MaravallLab/aMAZEing-maze/firmware/micropython/README.md

## code to run the PCA9685 on micropython

this leverages the Adafruit library which is currently not being actively developed.
