MaravallLab/aMAZEing-maze/docs/source/overview.rst

Overview
========

The Mice-Maze project provides a modular system for researchers to investigate rodent exploration behavior and sensory cue processing. The maze's flexible design includes interchangeable components and precise control of environmental stimuli. This documentation details the hardware and software requirements, assembly instructions, and usage guidelines.
