MaravallLab/aMAZEing-maze/docs/source/software.rst

Software Documentation
======================

Code Overview
-------------
- The repository includes:
  - Scripts for video processing and analysis.
  - Code to control maze stimuli and motor functions.

Running the Software
--------------------
1. Launch the Python script to initialize the experiment.
2. Adjust camera settings and stimuli parameters as needed.
3. Begin the experiment and monitor data collection.
