MaravallLab/aMAZEing-maze/docs/source/iindex.rst

.. Mice maze documentation master file, created by
   sphinx-quickstart on Thu Oct 10 16:22:44 2024.
   You can adapt this file completely to your liking, but it should at least
   contain the root `toctree` directive.

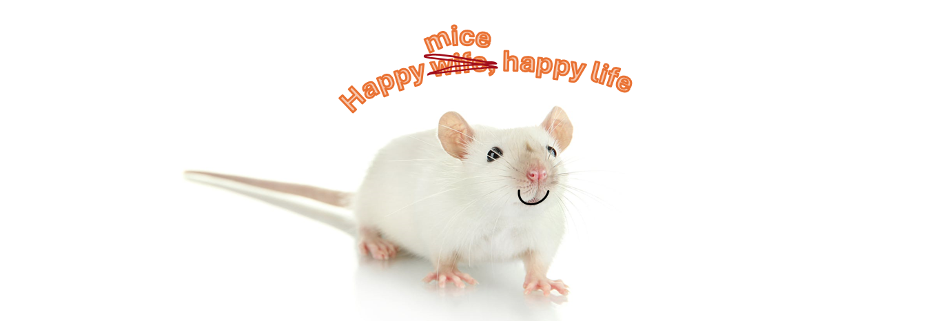
[picture p7: docs/source/_static/images/happy_mouse.png]


the aMAZEing maze documentation
=======================

**Active exploration setup for rodents**
This is a repository for building and running an experiment investigating how sensory cues affect mouse exploration in a modifiable maze.

Check out the :doc:`usage` section for further information, including how to :ref:`install <getting_started>` the project.

Welcome to Mice-Maze Documentation!
====================================

.. toctree::
   :maxdepth: 2
   :caption: Contents

   overview
   getting_started
   hardware
   software
   usage
   examples
   troubleshooting
   references

Indices and tables
==================
* :ref:`genindex`
* :ref:`modindex`
* :ref:`search`
