MaravallLab/aMAZEing-maze/archive/maze01/code/auditory/vocalisations/README.md

Recordings from the study ["Ultrasonic courtship vocalizations of male house mice contain distinct individual signatures"](https://doi.org/10.1016/j.anbehav.2020.09.006).  

Available on [Zenodo](https://zenodo.org/records/5771669)
