MaravallLab/aMAZEing-maze/docs/_static/images/mouse_ban.png

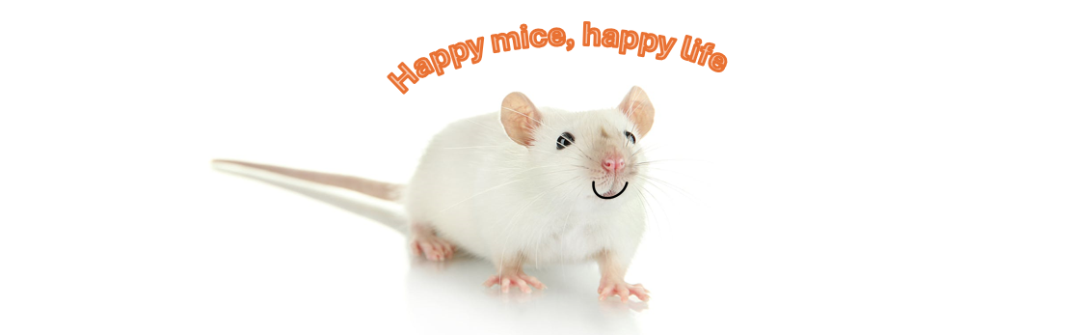
docs/_static/images/mouse_ban.png
