MaravallLab/aMAZEing-maze/docs/images/floor_plate.png

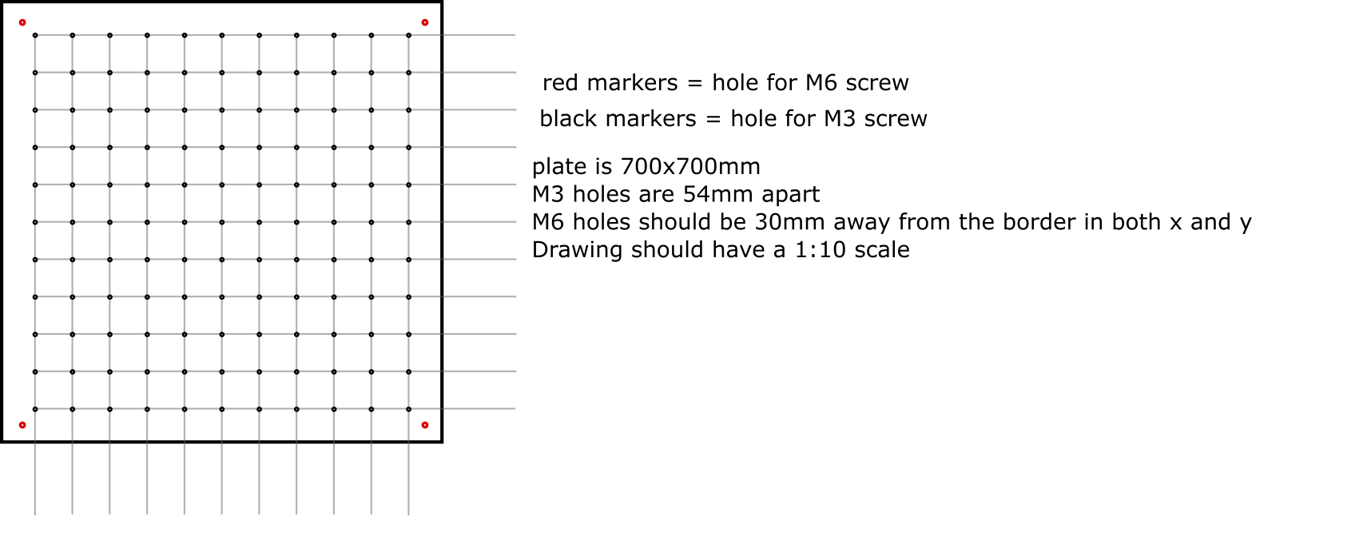
docs/images/floor_plate.png
