MaravallLab/aMAZEing-maze/docs/images/task_design.png

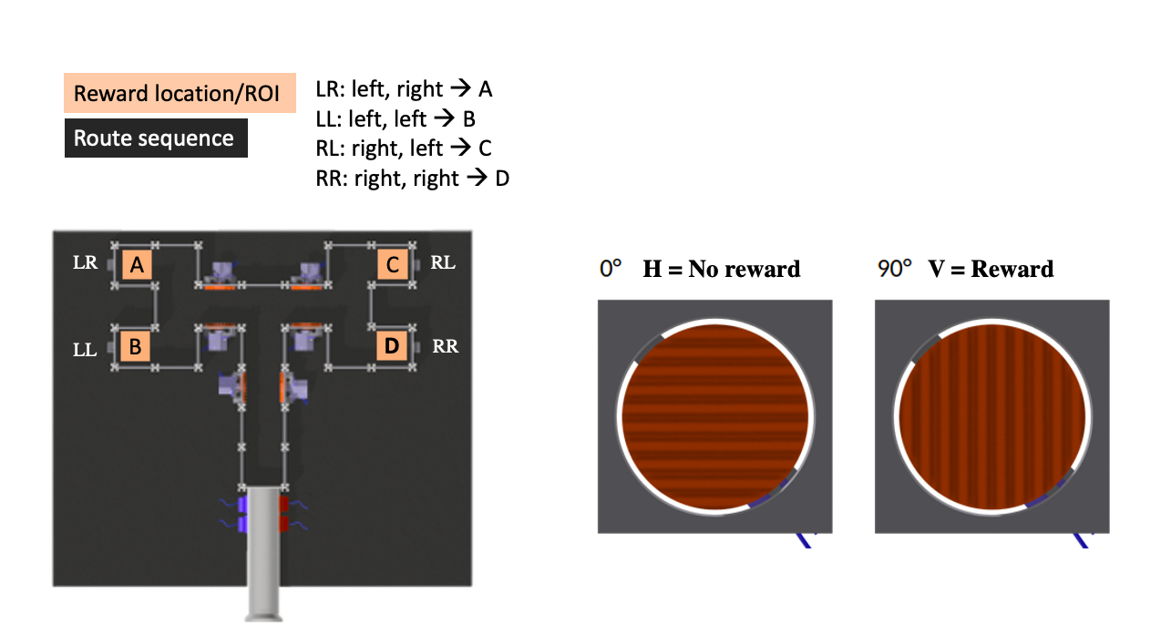
docs/images/task_design.png
