MaravallLab/aMAZEing-maze/docs/images/topplate.jpg

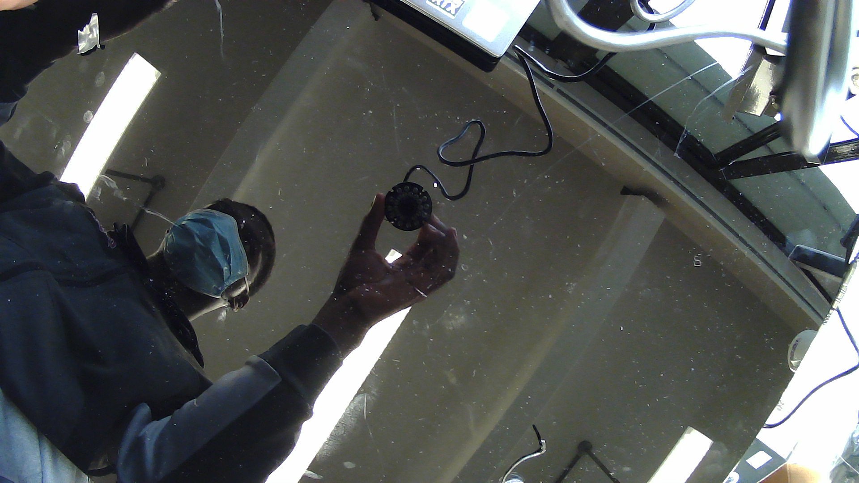
docs/images/topplate.jpg
