MaravallLab/aMAZEing-maze/hardware/drawings/task_design_2.png

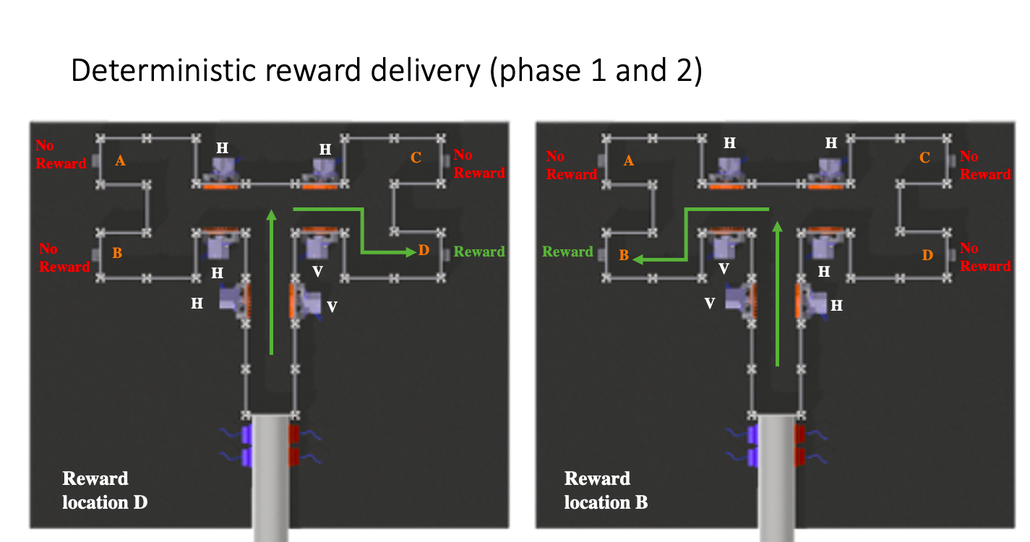
hardware/drawings/task_design_2.png
