MaravallLab/aMAZEing-maze/hardware/drawings/Task_design_3.png

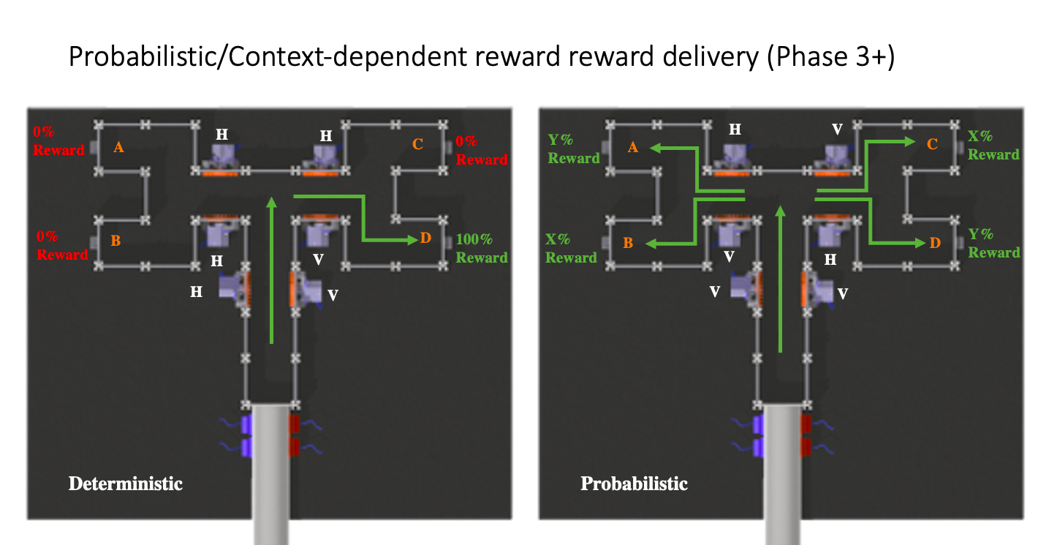
hardware/drawings/Task_design_3.png
