MaravallLab/aMAZEing-maze/hardware/photos/m3_16mm_screw_nut.jpg

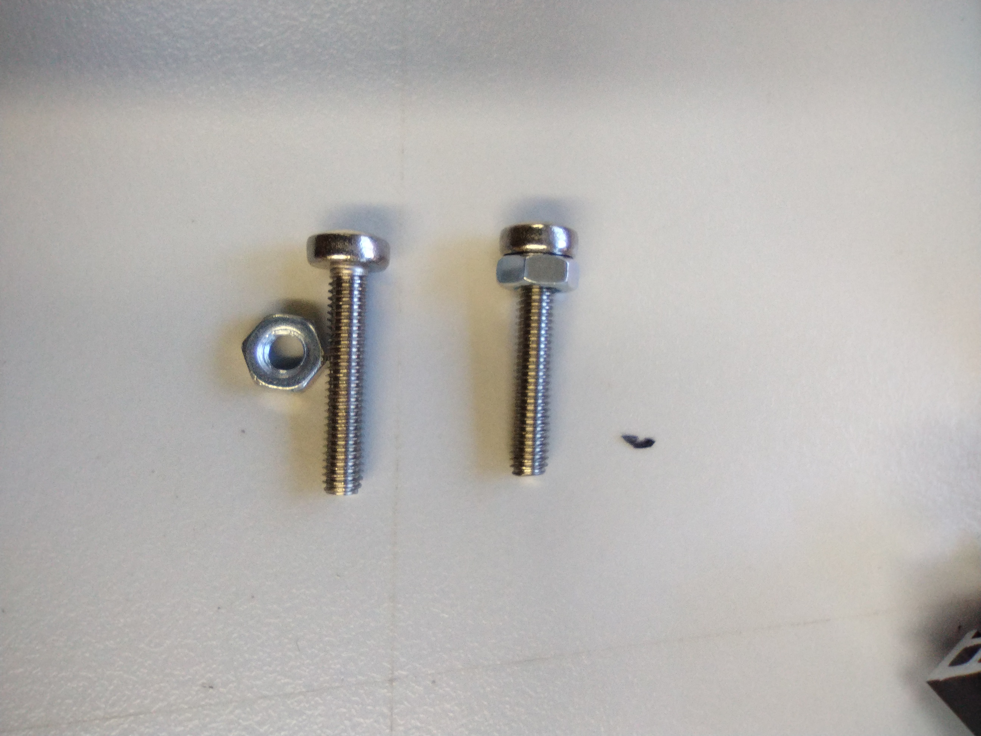
hardware/photos/m3_16mm_screw_nut.jpg
