MaravallLab/aMAZEing-maze/hardware/photos/topplate_view_infrared1.jpg

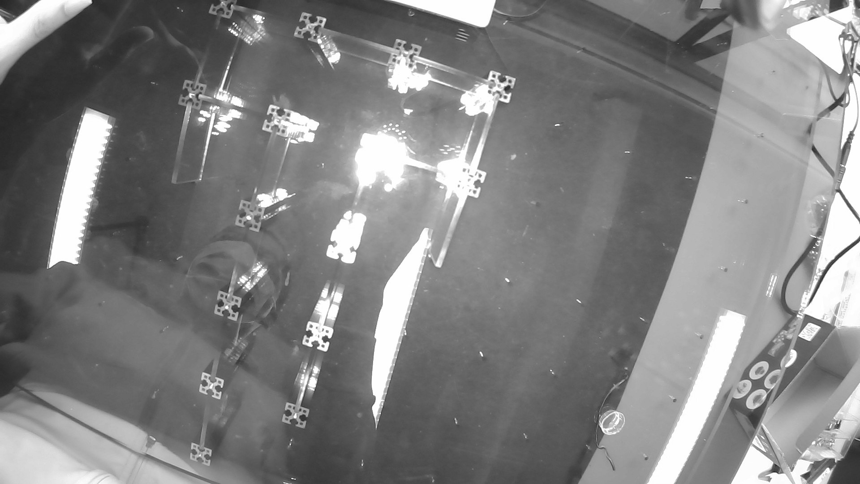
hardware/photos/topplate_view_infrared1.jpg
