MaravallLab/aMAZEing-maze/hardware/photos/topplate_view_infrared2.jpg

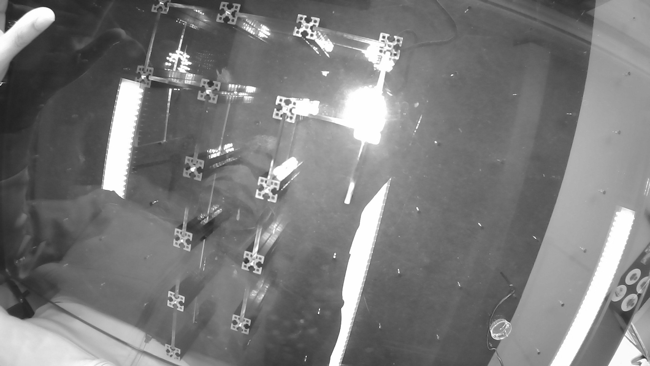
hardware/photos/topplate_view_infrared2.jpg
