MaravallLab/aMAZEing-maze/docs/hardware/materials.md

# Materials and suppliers

Where the lab bought the parts. These are the suppliers used in the United Kingdom; equivalents elsewhere are fine, the specifications on the [dimensions](dimensions.md) page are what matter.

## Suppliers

- local company for acrylic: https://www.brightonandhoveplastics.co.uk/index.php/products-acrylic_sheet/?k=23991:5::
- makerbeam shop https://www.makerbeam.com/makerbeamxl/makerbeamxl-15x15mm-profile-lengths-anodised-in-bl/
- screwfix for bolts https://www.screwfix.com/p/easyfix-bright-zinc-plated-pan-head-machine-screws-m3-x-20mm-25-pack/5875j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

For an 4 arm maze, we need (with spares) 50 side panels and 50 makerbeam posts, celing and floor plates.
Also need M3 bolts.
