MaravallLab/aMAZEing-maze/hardware/3dmodels/camera_holder/camera_box_v3.FCStd

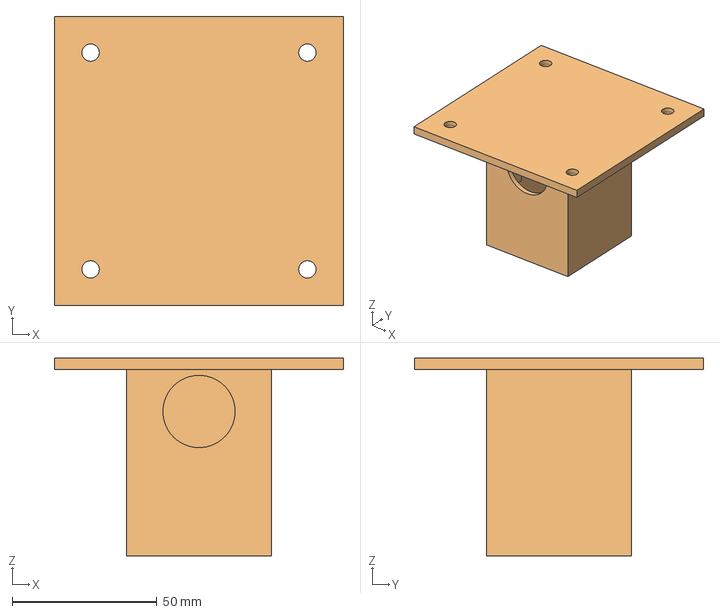
[picture p17: CAD file, 2026-04-02]
hardware/3dmodels/camera_holder/camera_box_v3.FCStd
100.0 x 100.0 x 68.5 mm
