MaravallLab/aMAZEing-maze/hardware/3dmodels/eight_arm_maze/eight_arm_maze_modified.FCStd

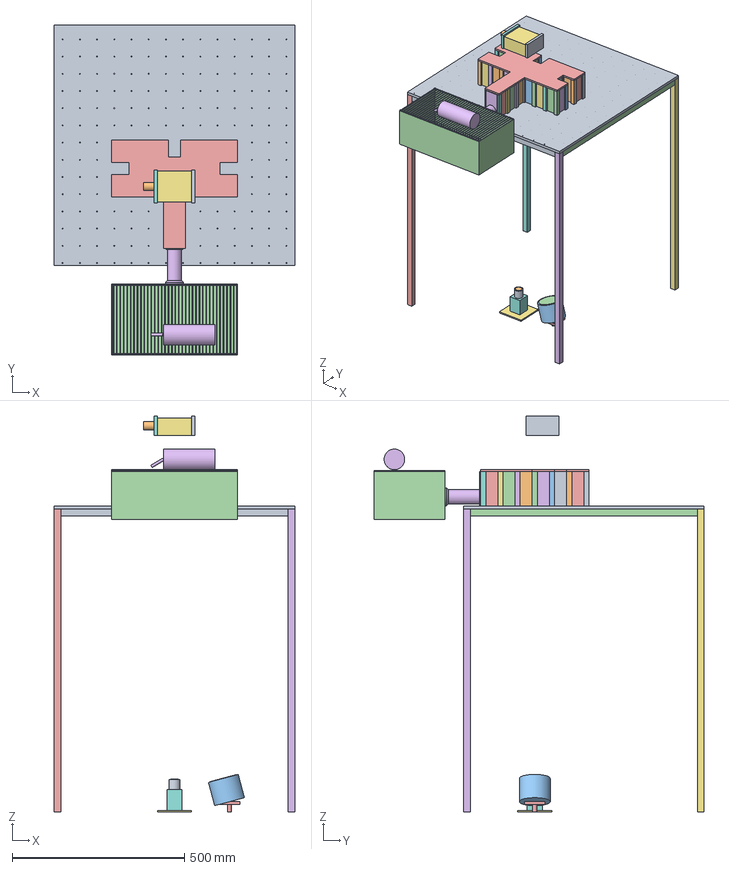
[picture p18: CAD file, 2026-09-24]
hardware/3dmodels/eight_arm_maze/eight_arm_maze_modified.FCStd
700.0 x 960.5 x 1151.0 mm
baseplate
panel001
panel002
panel003
panel004
panel005
panel006
panel007
panel008
panel009
panel010
panel011
panel012
panel013
panel014
panel015
panel016
panel017
panel018
panel019
panel020
panel021
panel022
panel023
panel024
panel025
panel026
panel027
panel028
panel029
panel030
panel031
panel032
panel033
panel034
panel035
panel036
panel037
post001
post002
post003
post004
post005
post006
post007
post008
post009
post010
post011
post012
post013
post014
post015
post016
post017
post018
post019
post020
post021
post022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
