MaravallLab/aMAZEing-maze/hardware/3dmodels/electronics_enclosure_bottom_v2.stl

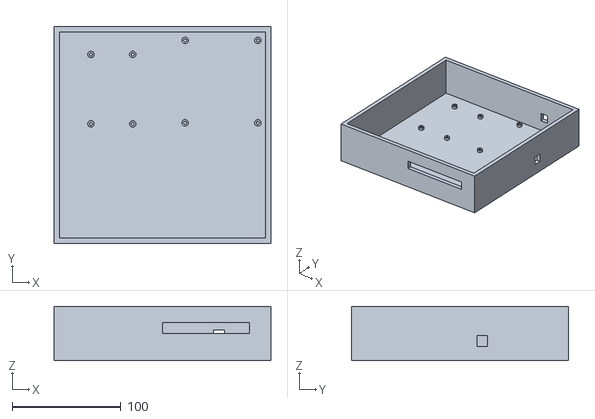
[picture p19: CAD file, 2026-04-02]
hardware/3dmodels/electronics_enclosure_bottom_v2.stl
200.0 x 200.0 x 50.0
