MaravallLab/aMAZEing-maze/hardware/3dmodels/maze_parts/maze_cover/maze_cover_B_v4.FCStd

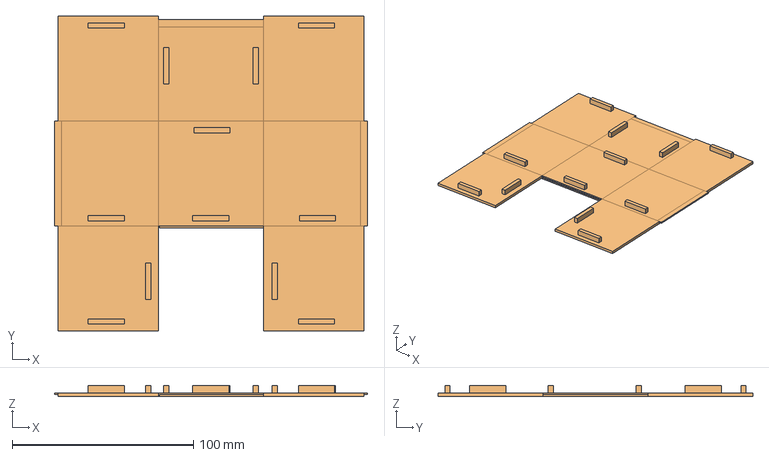
[picture p20: CAD file, 2026-04-02]
hardware/3dmodels/maze_parts/maze_cover/maze_cover_B_v4.FCStd
173.0 x 174.0 x 6.00 mm
