MaravallLab/aMAZEing-maze/hardware/3dmodels/maze_parts/tunnel/transfer_tunnel.FCStd

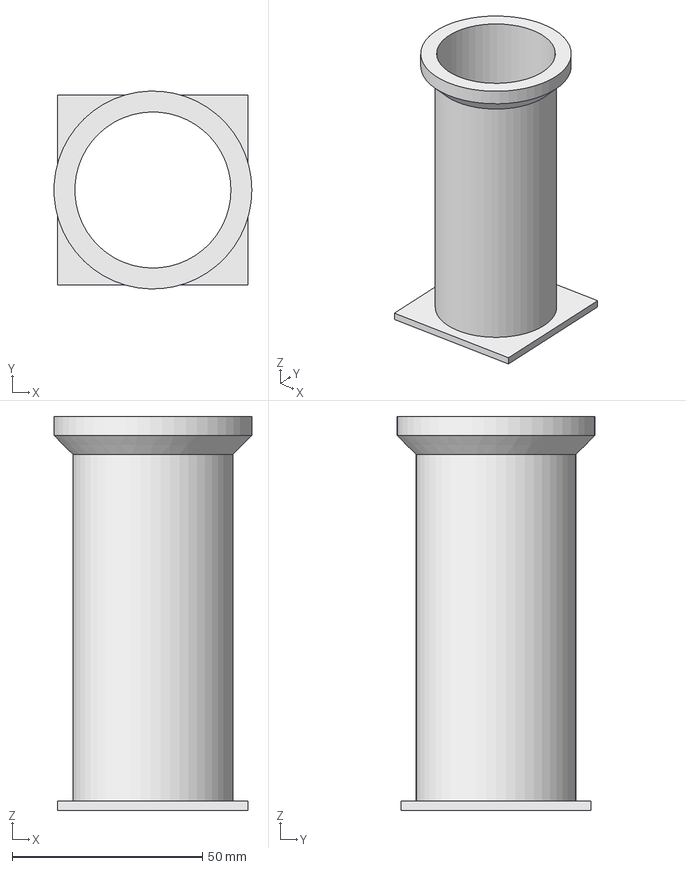
[picture p21: CAD file, 2026-04-02]
hardware/3dmodels/maze_parts/tunnel/transfer_tunnel.FCStd
52.0 x 52.0 x 103.5 mm
