MaravallLab/aMAZEing-maze/hardware/3dmodels/moveable_wall/cog calibration/new_wall_maze_v15.FCStd

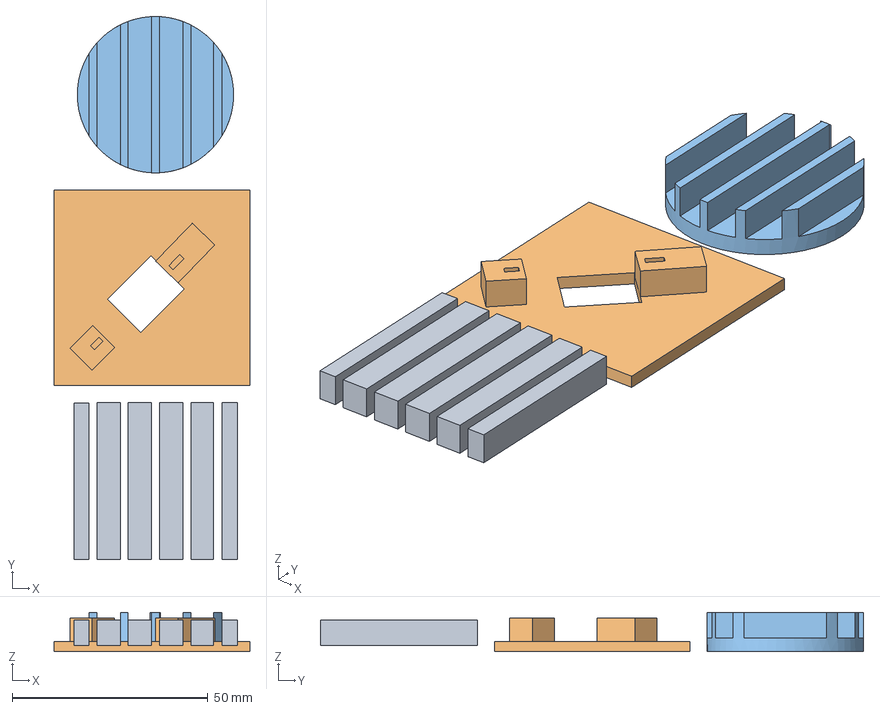
[picture p22: CAD file, 2026-04-02]
hardware/3dmodels/moveable_wall/cog calibration/new_wall_maze_v15.FCStd
50.0 x 138.9 x 10.0 mm
