MaravallLab/aMAZEing-maze/hardware/3dmodels/reward delivery/reward_chute_Wall_v4.FCStd

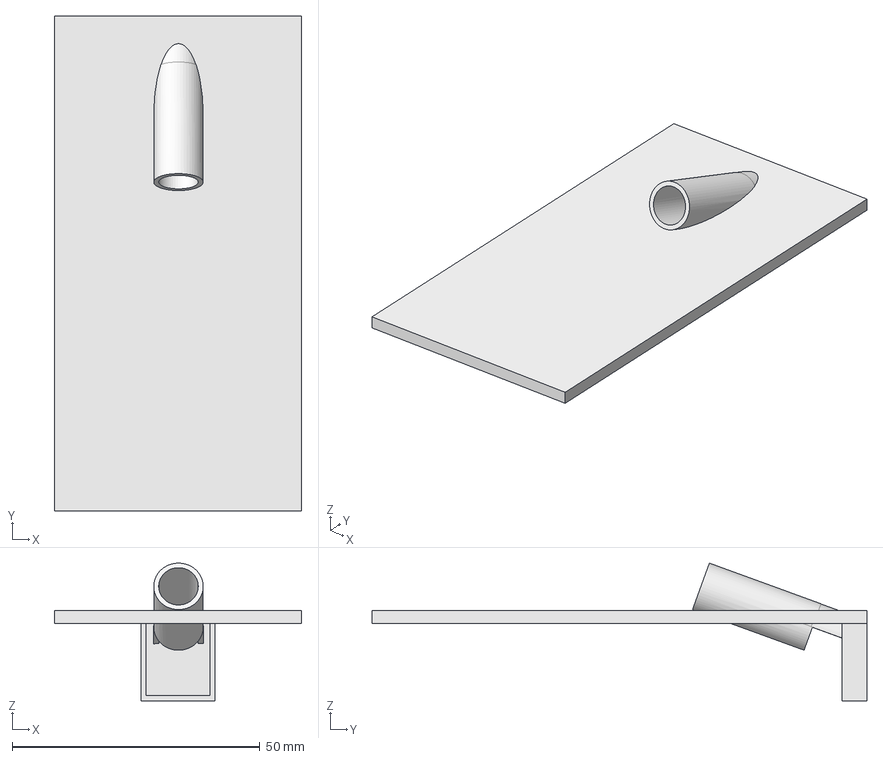
[picture p23: CAD file, 2026-04-02]
hardware/3dmodels/reward delivery/reward_chute_Wall_v4.FCStd
50.0 x 100.0 x 27.8 mm
