MaravallLab/aMAZEing-maze/hardware/3dmodels/camera_holder/camera_lid_v1.stl

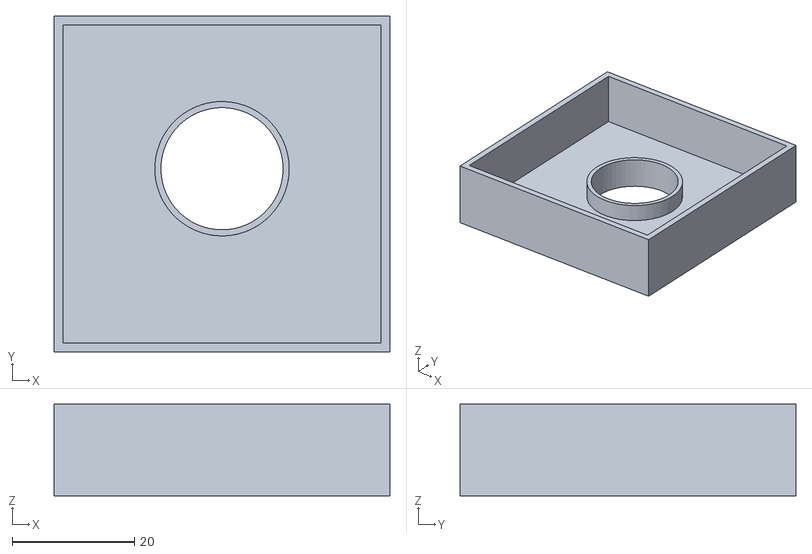
[picture p24: CAD file, 2026-04-02]
hardware/3dmodels/camera_holder/camera_lid_v1.stl
55.0 x 55.0 x 15.0
