MaravallLab/aMAZEing-maze/hardware/3dmodels/electronics_enclosure_lid_v2.stl

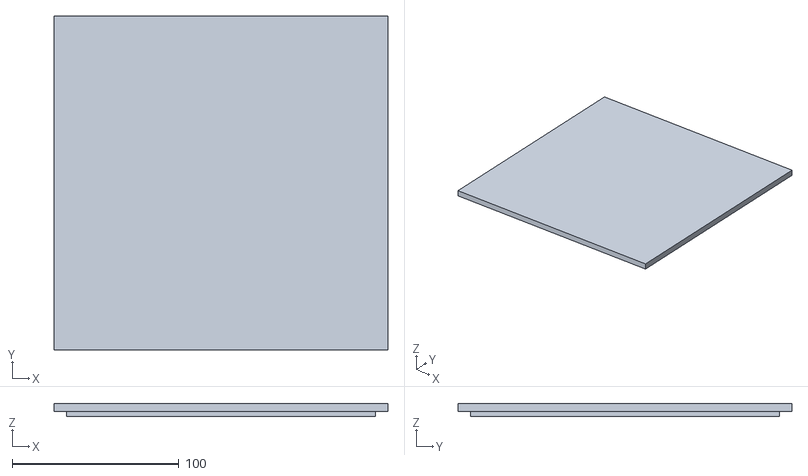
[picture p25: CAD file, 2026-04-02]
hardware/3dmodels/electronics_enclosure_lid_v2.stl
200.0 x 200.0 x 8.00
