MaravallLab/aMAZEing-maze/hardware/3dmodels/maze_parts/maze_cover/maze_cover_A_v3.FCStd

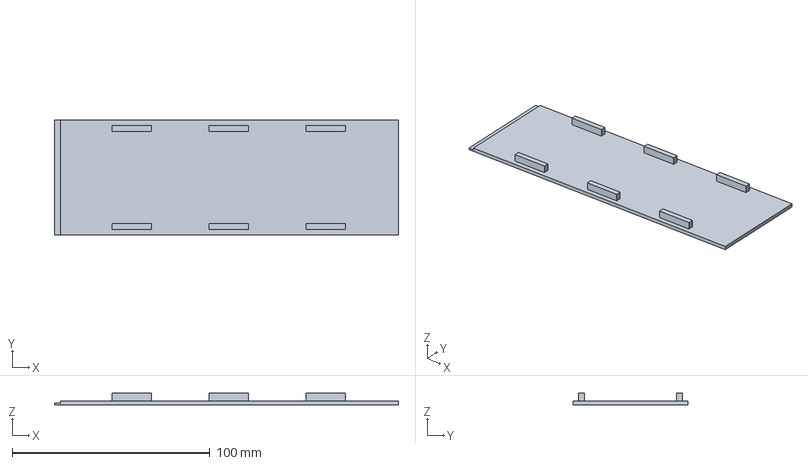
[picture p26: CAD file, 2026-04-02]
hardware/3dmodels/maze_parts/maze_cover/maze_cover_A_v3.FCStd
174.0 x 58.0 x 6.00 mm
