MaravallLab/aMAZEing-maze/hardware/3dmodels/electronics_enclosure_v2.FCStd

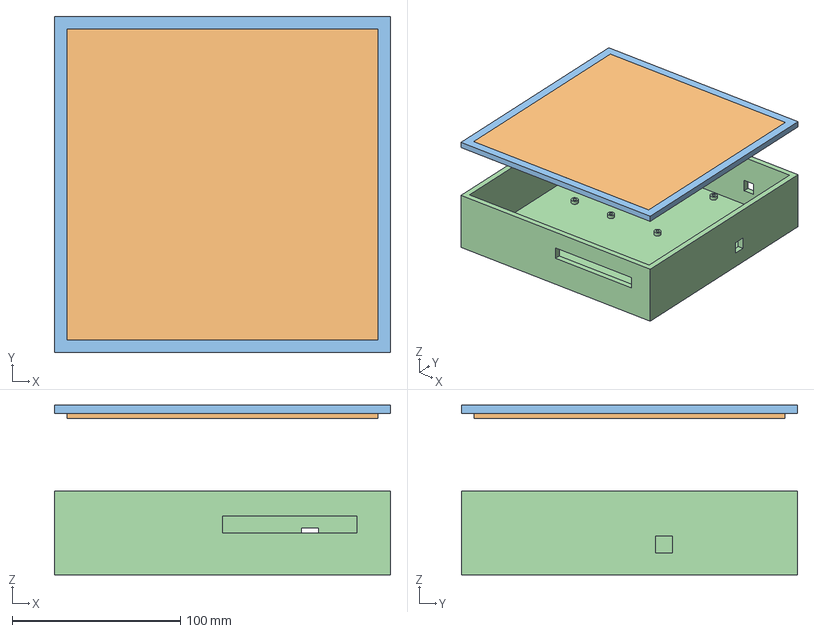
[picture p27: CAD file, 2026-04-02]
hardware/3dmodels/electronics_enclosure_v2.FCStd
200.0 x 200.0 x 101.0 mm
lid
