MaravallLab/aMAZEing-maze/hardware/3dmodels/maze_parts/maze_cover/maze_cover_C_v3.FCStd

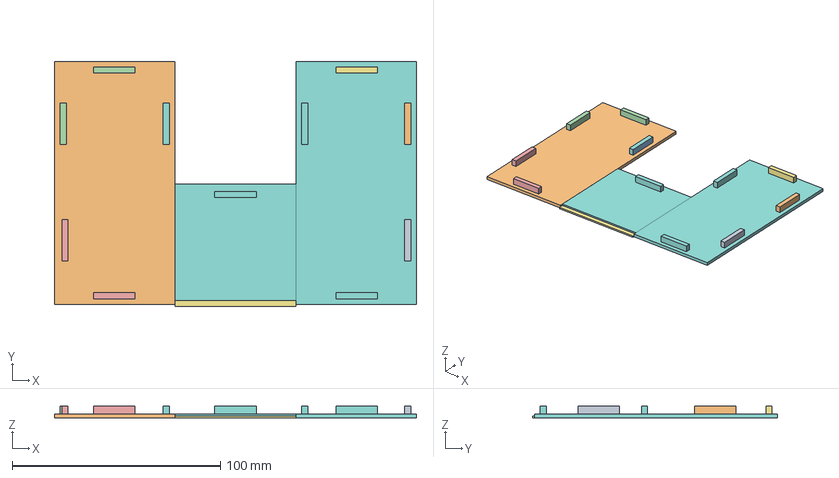
[picture p28: CAD file, 2026-04-02]
hardware/3dmodels/maze_parts/maze_cover/maze_cover_C_v3.FCStd
174.0 x 118.0 x 6.00 mm
