MaravallLab/aMAZEing-maze/hardware/3dmodels/maze_parts/tunnel/Maze2_transfer_tunnel_higher.walls.3mf

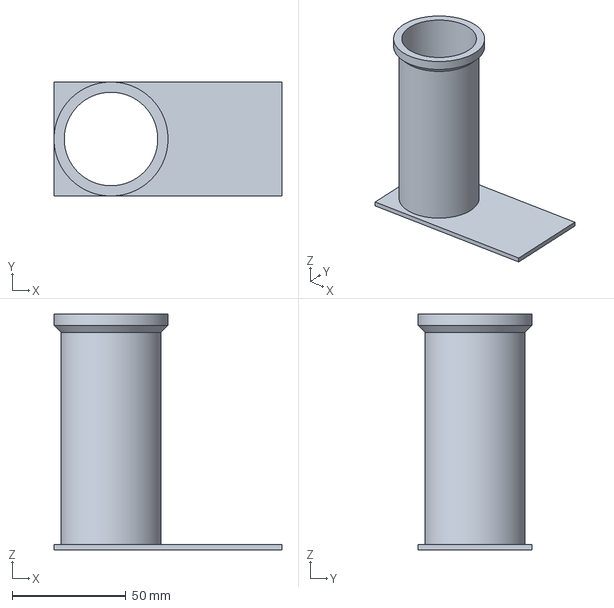
[picture p29: CAD file, 2026-04-02]
hardware/3dmodels/maze_parts/tunnel/Maze2_transfer_tunnel_higher.walls.3mf
100.0 x 50.0 x 103.5 mm
