MaravallLab/aMAZEing-maze/archive/maze01/3dmodels/maze_parts/archive/spout/spout_holder-main_plate.amf

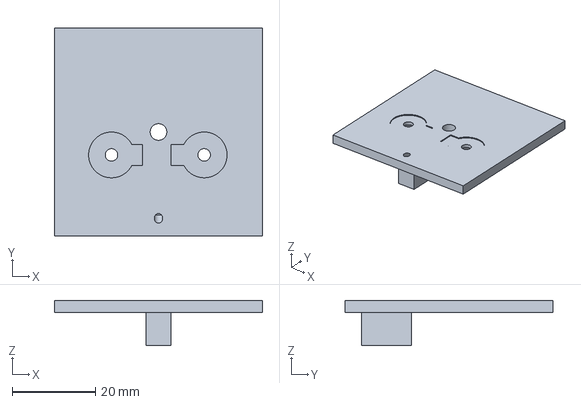
[picture p30: CAD file, 2026-04-02, an earlier design]
archive/maze01/3dmodels/maze_parts/archive/spout/spout_holder-main_plate.amf
50.0 x 50.0 x 10.9 mm
