MaravallLab/aMAZEing-maze/archive/maze01/3dmodels/archive/electronics_enclosure.FCStd

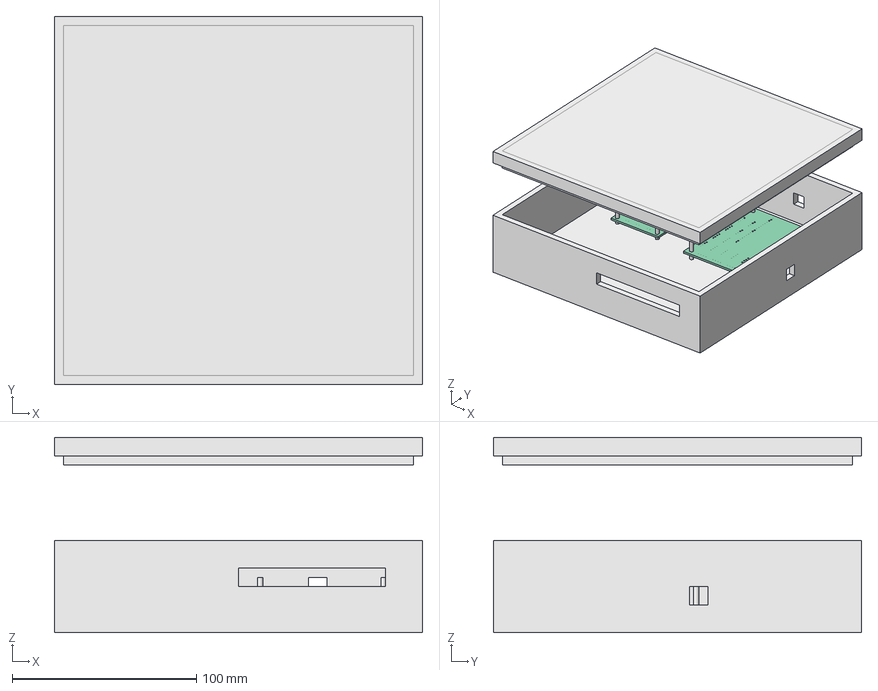
[picture p31: CAD file, 2026-04-02, an earlier design]
archive/maze01/3dmodels/archive/electronics_enclosure.FCStd
200.0 x 200.0 x 106.0 mm
Pcb_ebcb
Pcb_b27c
box_bottom
lid
