MaravallLab/aMAZEing-maze/(list of files, cad)

Other CAD files:
hardware/3dmodels/maze_parts/tunnel/transfer_tunnel-Cut.amf
hardware/3dmodels/moveable_wall/new_wall_maze_v13.FCStd
hardware/3dmodels/archive/cam_box.scad
hardware/3dmodels/archive/syringe_holder.scad
archive/maze01/3dmodels/archive/cam_box.scad
archive/maze01/3dmodels/archive/syringe_holder.scad
archive/maze01/3dmodels/archive/electronics_enclosure/enclosure.FCStd
archive/maze01/3dmodels/archive/gratings/gratings.scad
archive/maze01/3dmodels/archive/gratings/gratings.stl
archive/maze01/3dmodels/archive/habituation_sink/habituation_sink.3mf
archive/maze01/3dmodels/archive/habituation_sink/habituation_sink.stl
archive/maze01/3dmodels/archive/moveable_wall.3mf
archive/maze01/3dmodels/archive/moveable_wall.stl
archive/maze01/3dmodels/archive/new_wall_maze.FCStd
archive/maze01/3dmodels/archive/new_wall_maze_cog_v4.stl
archive/maze01/3dmodels/archive/new_wall_maze_cog_v6.FCStd
archive/maze01/3dmodels/archive/new_wall_maze_cog_v6.stl
archive/maze01/3dmodels/archive/new_wall_maze_cog_v7.FCStd
archive/maze01/3dmodels/archive/new_wall_maze_cog_v7_test.FCStd
archive/maze01/3dmodels/archive/new_wall_maze_cog_v7_test.stl
archive/maze01/3dmodels/archive/new_wall_maze_cog_v8.FCStd
archive/maze01/3dmodels/archive/new_wall_maze_cog_v8.stl
archive/maze01/3dmodels/archive/new_wall_maze_cog_v8_test.FCStd
archive/maze01/3dmodels/archive/new_wall_maze_cog_v8_test.stl
archive/maze01/3dmodels/archive/new_wall_maze_cog_v9.FCStd
archive/maze01/3dmodels/archive/new_wall_maze_cog_v9_test.FCStd
archive/maze01/3dmodels/archive/new_wall_maze_cog_v9_test.stl
archive/maze01/3dmodels/archive/new_wall_maze_v2.FCStd
archive/maze01/3dmodels/archive/new_wall_maze_v2.stl
archive/maze01/3dmodels/archive/new_wall_maze_v3.FCStd
archive/maze01/3dmodels/archive/new_wall_maze_v3.stl
archive/maze01/3dmodels/archive/new_wall_maze_v4.FCStd
archive/maze01/3dmodels/archive/new_wall_maze_v5.FCStd
archive/maze01/3dmodels/archive/new_wall_maze_v5.stl
archive/maze01/3dmodels/archive/new_wall_maze_v9.FCStd
archive/maze01/3dmodels/archive/new_wall_maze_v9.stl
archive/maze01/3dmodels/archive/recessed_spout/recessed spout.3mf
archive/maze01/3dmodels/archive/recessed_spout/transfer_tunnel.3mf
archive/maze01/3dmodels/archive/solid_reward_tray/cog.stl
archive/maze01/3dmodels/archive/solid_reward_tray/funnel.stl
archive/maze01/3dmodels/archive/solid_reward_tray/servo_tray.stl
archive/maze01/3dmodels/archive/solid_reward_tray/slider_old.stl
archive/maze01/3dmodels/archive/solid_reward_tray/slider_version_1.stl
archive/maze01/3dmodels/archive/solid_reward_tray/slider_version_2.stl
archive/maze01/3dmodels/archive/solid_reward_tray/solid reward wall.3mf
archive/maze01/3dmodels/camera_holder/camera_box_v2.FCStd
archive/maze01/3dmodels/camera_holder/camera_box_v2.stl
archive/maze01/3dmodels/camera_holder/camera_box_v3.stl
archive/maze01/3dmodels/maze_parts/archive/spout/spout_holder-holder_left.amf
archive/maze01/3dmodels/maze_parts/archive/spout/spout_holder-holder_right.amf
archive/maze01/3dmodels/maze_parts/archive/spout/spout_holder.scad
archive/maze01/3dmodels/maze_parts/archive/transfer_tunnel.stl
archive/maze01/3dmodels/maze_parts/maze_cover/archive/maze_cover_A_v2.FCStd
archive/maze01/3dmodels/maze_parts/maze_cover/archive/maze_cover_A_v2.stl
archive/maze01/3dmodels/maze_parts/maze_cover/archive/maze_cover_B_v2.FCStd
archive/maze01/3dmodels/maze_parts/maze_cover/archive/maze_cover_B_v2.stl
archive/maze01/3dmodels/maze_parts/maze_cover/archive/maze_cover_C_v2.FCStd
archive/maze01/3dmodels/maze_parts/maze_cover/archive/maze_cover_C_v2.stl
archive/maze01/3dmodels/maze_parts/maze_cover/maze_cover_A_v3.stl
archive/maze01/3dmodels/maze_parts/maze_cover/maze_cover_B_v3.FCStd
archive/maze01/3dmodels/maze_parts/maze_cover/maze_cover_B_v3.stl
archive/maze01/3dmodels/maze_parts/maze_cover/maze_cover_B_v4.stl
archive/maze01/3dmodels/maze_parts/maze_cover/maze_cover_C_v3.stl
archive/maze01/3dmodels/maze_parts/tunnel/transfer_tunnel-Cut.amf
archive/maze01/3dmodels/moveable_wall/cog calibration/new_wall_maze_v14.FCStd
archive/maze01/3dmodels/moveable_wall/new_wall_maze_v10.3mf
archive/maze01/3dmodels/moveable_wall/new_wall_maze_v10.FCStd
archive/maze01/3dmodels/moveable_wall/new_wall_maze_v10.stl
archive/maze01/3dmodels/moveable_wall/new_wall_maze_v11.FCStd
archive/maze01/3dmodels/moveable_wall/new_wall_maze_v11.stl
archive/maze01/3dmodels/moveable_wall/new_wall_maze_v13.FCStd
archive/maze01/3dmodels/reward delivery/reward_chute_Wall_v3.3mf
archive/maze01/3dmodels/reward delivery/reward_chute_Wall_v3.FCStd
archive/maze01/3dmodels/reward delivery/reward_chute_Wall_v3.stl
archive/maze01/3dmodels/reward delivery/reward_chute_Wall_v4.3mf
archive/maze01/3dmodels/reward delivery/reward_chute_Wall_v4.stl
hardware/3dmodels/archive/electronics_enclosure/enclosure.FCStd
hardware/3dmodels/archive/gratings/gratings.scad
hardware/3dmodels/archive/gratings/gratings.stl
hardware/3dmodels/archive/habituation_sink/habituation_sink.3mf
hardware/3dmodels/archive/habituation_sink/habituation_sink.stl
hardware/3dmodels/archive/moveable_wall.3mf
hardware/3dmodels/archive/moveable_wall.stl
hardware/3dmodels/archive/new_wall_maze.FCStd
hardware/3dmodels/archive/new_wall_maze_cog_v4.stl
hardware/3dmodels/archive/new_wall_maze_cog_v6.FCStd
hardware/3dmodels/archive/new_wall_maze_cog_v6.stl
hardware/3dmodels/archive/new_wall_maze_cog_v7.FCStd
hardware/3dmodels/archive/new_wall_maze_cog_v7_test.FCStd
hardware/3dmodels/archive/new_wall_maze_cog_v7_test.stl
hardware/3dmodels/archive/new_wall_maze_cog_v8.FCStd
hardware/3dmodels/archive/new_wall_maze_cog_v8.stl
hardware/3dmodels/archive/new_wall_maze_cog_v8_test.FCStd
hardware/3dmodels/archive/new_wall_maze_cog_v8_test.stl
hardware/3dmodels/archive/new_wall_maze_cog_v9.FCStd
hardware/3dmodels/archive/new_wall_maze_cog_v9_test.FCStd
hardware/3dmodels/archive/new_wall_maze_cog_v9_test.stl
hardware/3dmodels/archive/new_wall_maze_v2.FCStd
hardware/3dmodels/archive/new_wall_maze_v2.stl
hardware/3dmodels/archive/new_wall_maze_v3.FCStd
hardware/3dmodels/archive/new_wall_maze_v3.stl
hardware/3dmodels/archive/new_wall_maze_v4.FCStd
hardware/3dmodels/archive/new_wall_maze_v5.FCStd
hardware/3dmodels/archive/new_wall_maze_v5.stl
hardware/3dmodels/archive/new_wall_maze_v9.FCStd
hardware/3dmodels/archive/new_wall_maze_v9.stl
hardware/3dmodels/archive/recessed_spout/recessed spout.3mf
hardware/3dmodels/archive/recessed_spout/transfer_tunnel.3mf
hardware/3dmodels/archive/solid_reward_tray/cog.stl
hardware/3dmodels/archive/solid_reward_tray/funnel.stl
hardware/3dmodels/archive/solid_reward_tray/servo_tray.stl
hardware/3dmodels/archive/solid_reward_tray/slider_old.stl
hardware/3dmodels/archive/solid_reward_tray/slider_version_1.stl
hardware/3dmodels/archive/solid_reward_tray/slider_version_2.stl
hardware/3dmodels/archive/solid_reward_tray/solid reward wall.3mf
hardware/3dmodels/camera_holder/camera_box_v2.FCStd
hardware/3dmodels/camera_holder/camera_box_v2.stl
hardware/3dmodels/camera_holder/camera_box_v3.stl
hardware/3dmodels/maze_parts/archive/spout/spout_holder-holder_left.amf
hardware/3dmodels/maze_parts/archive/spout/spout_holder-holder_right.amf
hardware/3dmodels/maze_parts/archive/spout/spout_holder.scad
hardware/3dmodels/maze_parts/archive/transfer_tunnel.stl
hardware/3dmodels/maze_parts/maze_cover/archive/maze_cover_A_v2.FCStd
hardware/3dmodels/maze_parts/maze_cover/archive/maze_cover_A_v2.stl
hardware/3dmodels/maze_parts/maze_cover/archive/maze_cover_B_v2.FCStd
hardware/3dmodels/maze_parts/maze_cover/archive/maze_cover_B_v2.stl
hardware/3dmodels/maze_parts/maze_cover/archive/maze_cover_C_v2.FCStd
hardware/3dmodels/maze_parts/maze_cover/archive/maze_cover_C_v2.stl
hardware/3dmodels/maze_parts/maze_cover/maze_cover_A_v3.stl
hardware/3dmodels/maze_parts/maze_cover/maze_cover_B_v3.FCStd
hardware/3dmodels/maze_parts/maze_cover/maze_cover_B_v3.stl
hardware/3dmodels/maze_parts/maze_cover/maze_cover_B_v4.stl
hardware/3dmodels/maze_parts/maze_cover/maze_cover_C_v3.stl
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
