MaravallLab/aMAZEing-maze/docs/source/getting_started.rst

.. _getting_started:

Getting Started
===============

Prerequisites
-------------
1. **Hardware**:
   - A PC with sufficient processing power for video analysis and Arduino control.
   - Required components (detailed in the Hardware Documentation section).
2. **Software**:
   - Python (minimum version: 3.8).
   - Arduino IDE for programming hardware controllers.
   - Git for accessing the repository.

Installation Instructions
--------------------------
1. Clone the repository:
   ```bash
   git clone https://github.com/Sussex-Neuroscience/mice-maze.git
   ```
2. Install required Python libraries:
   ```bash
   pip install -r requirements.txt
   ```
3. Set up Arduino libraries and upload the necessary sketches to the Arduino.
4. Install the camera driver (if needed).
