MaravallLab/aMAZEing-maze/analysis/auditory/model_validation/HANDOFF.md

# Handoff summary - model_validation (for the model-author instance)

A compact, pasteable status of the validation pipeline the repo-side instance
built from your spec + decisions. Architecture, baked-in decisions, and the
actual day-1 numbers. Read alongside `QUICKGUIDE.md` (intuition + how to run).

## What was built
A read-only Python package `analysis/auditory/model_validation/` (touches no
experiment code, no recordings; writes only to a chosen out_dir). It runs the
ordered pipeline: cohort filter → sanity → model-free design analysis → bigram
latent regressors + collinearity → recovery (the gate) → Phase-2 Bayesian LOO →
day-2 secondary. CLI: `run_validation.py`. 9/9 unit tests pass.

## Decisions baked in (per your direction)
- **Bigram emissions**: P(o_t | o_{t-1}, z) = that context's grammar matrix.
  Single-tone emissions give S≡0 (both grammars share a uniform tone marginal).
  Markov-switching observer; S is group-invariant by construction.
- **Complexity = surprise under the FULL trained grammar** (recomputed from the
  `symbols` string), NOT the logged `mean_bits` (which collapses secondary≈rare).
- **Behavioural target = EE−SC PI** (EE−SC)/(EE+SC), matching the existing
  `summary_analysis` convention exactly. Silent/vocalisation = reference only.
- **Structural params fixed, never fitted**: grammar matrices, context transition
  (self≈0.99), B-D α/target/prior, V_EE=1 / V_SC=0. Only (w0, wr, wV, wS) free.
- **Group is a factor everywhere** (the octave-trill-vs-sweep intrinsic-grammar
  confound). Recovery includes an intrinsic-grammar generator + grammar-identity
  nuisance weight so wS can't be a relabelled intrinsic preference.
- **Recovery gates interpretation**: no wS is interpreted until recovery passes.
- **Day 1 primary; day 2 separate secondary** (model-free + block time-course).
- **Cohort**: animal 13533 excluded (light artifact, both days) via a named
  `EXCLUDED_ANIMALS` filter with a reason; the swap session excluded; duplicate
  filings de-duplicated. Reinstating 13533 once cleaned = delete one line.

## Day-1 results (current run)
- **Cohort**: 33 distinct mice after exclusions; **group balance 16 / 17**.
  Cross-session group inconsistencies: none. trials↔grammar_samples label
  mismatches: 0. (Phase-2 design uses 128 arm-blocks / 32 mice.)
- **Model-free** `log1p(dwell) ~ environment × tier × group + (1|mouse)`:
  - EE−SC effect **positive in both groups** - group 1 **+0.45 (p=.002)**,
    group 2 **+0.27 (p=.07)** - **group-consistent sign = True** ⇒ semantic, not
    the intrinsic-grammar confound.
  - Simple effect by tier: **dominant +0.45 (p=.008)**, secondary +0.24 (p=.10),
    rare +0.09 (p=.48); env×group n.s. at every tier. So the EE−SC preference is
    concentrated at the predictable (dominant) tier and attenuates with
    complexity.
- **Collinearity**: corr(r, S) = **0.001** (r and S essentially orthogonal - the
  design separated fluency from semantics in practice). VIFs ≈ 1.0-1.4. ΔV
  between-arm variance ≈ 3e-8 (≈ 0): within-arm learning has plateaued, so wV does
  little work; the real contrast is r (complexity) vs S (semantics).
- **Recovery gate** (full sims: 500 param-recovery, 50 confusion): **PASSED**.
  wS recovered at 0/0.5/1.0/2.0 with tight CIs; **false-positive rate at wS=0 is
  5.4%** (≈ nominal 5%). Model confusion: bd-generated prefer-`full` 0.20,
  full-generated 1.00, **intrinsic-grammar-generated 0.00 with wS(full) = −0.07**
  (no spurious positive). ⇒ wS is estimable and not a relabelled intrinsic-grammar
  effect.
- **Control arms** (informational, not gated): visited-arm mean dwell silent 14.3s
  > grammar 11.8s, vocalisation 16.8s - test-day avoidance of the grammar tones,
  vocalisation attractive (echoes the old experiment's D1 vocalisation anomaly).
- **Day-2 secondary** block time-course: PI 0.26 → 0.02 → −0.04 → −0.09 across the
  four 15-min blocks; slope **−0.11/block (p<.05)** = decay (extinction signature).

## FINAL RESOLUTION - tier-restricted S + grain comparison (supersedes the per-block Phase 2 below)

Two fixes landed after the per-block Phase 2: (1) **tier-restricted S emissions** -
score transitions under the tier-restricted generative distributions, removing the
i→i+3 secondary sign-flip (S is now correctly EE+/SC− at every tier); (2) **fit at
the grain where the effect lives**, after diagnosing that the per-block Dirichlet
fits BELOW the effect's grain (per-arm-block dwell noise swamps a real but small
effect → all weights shrink → near-flat predictions).

**Cohort:** 32 explorers. The 33rd (mouse 13672) is a non-explorer (0 s dwell, 0
arms visited), excluded consistently - this resolves the long-standing 33-vs-32.

**Grain comparison - wS by observation grain (tier-restricted S, wr,wV≥0):**

| grain | wS mean | 95% HDI | P(wS>0) | within-grain LOO (full vs intercept) |
|---|---|---|---|---|
| A - per-block (anchor) | +0.049 | [−0.013, 0.108] | 0.94 | tied |
| B - per-mouse cell-mean | +0.77 | [0.09, 1.70] | 1.00 | full wins (Δelpd≈17, wt 0.91) |
| C - per-tier EE−SC PI | +0.15 | [0.10, 0.20] | 1.00 | full wins (Δelpd≈14.5, wt 1.0) |

wS magnitudes are **not** comparable across grains (different links/parameterisation);
what matters is the HDI **includes 0 at per-block, EXCLUDES 0 at both coarser grains**.
At the cell grain `wr` is also reliably positive (+0.36, [0.03, 0.81]) - the fluency
gradient recovers too. Leave-one-mouse-out wS (PI grain) is sign-stable across all 32
drops (+0.16…+0.20). The cell-mean posterior-predictive now matches the observed
7-arm pattern (EE-dominant peak, EE descending, SC low, silent high); SC-secondary is
the one weak cell (residual i→i+3). Figures: `grainB_cellmean_ppc.png`,
`grainC_tierPI_ppc.png`, `grain_weights_wS.png`; numbers in `grain_results.json`.

**FRAMING (do not overclaim):** the cell/PI fit **re-expresses the model-free result
as a process model** (4 weights → ~7 cell means / 3 PIs) - a **mechanistic
illustration, NOT independent statistical validation**. The statistical weight remains
the design-based model-free analysis. The per-block flatness was a **grain mismatch**,
not absence of effect. **LOO is not compared across grains** (non-comparable
observation models). A value-gates-fluency form is future work.

**Bottom line:** robust model-free EE−SC effect; with correctly-signed (tier-restricted)
S and fitting at the effect's grain, the generative model reproduces the full
behavioural pattern and yields a reliably-positive semantic weight - a mechanistic
illustration of the model-free result, with the per-block under-fit diagnosed as a
grain mismatch.

---

## Phase 2 - out-of-sample model comparison (day 1; 128 arm-blocks / 32 mice)
*(This is the per-block GRAIN A anchor - kept for the comparison above; not the result.)*
The mingw compiler was installed, so the exact PyMC `az.compare` LOO ran
(compiled NUTS, ~20-35 s/model); the frequentist leave-one-mouse-out CV agrees.

- **LOO ranking** (elpd_loo, higher = better; B-D-constrained model wr,wV≥0):
  `full` rank 0 (**901.87**, stacking weight 0.55) **≈ tied with `intercept`**
  (901.19, weight 0.45) > `bd_baseline` (900.40) > `fluency` (899.85). So `full`
  still ranks #1 but Δelpd ≈ 0.7 vs dse ≈ 4.3 - the predictors add **almost nothing
  out of sample**. (Constraining wr,wV≥0 removed the earlier unconstrained run's
  spurious negative-wr fluency edge, which is why fluency/bd fell below intercept.)
- **wS posterior**: mean **+0.078, 95% HDI [0.014, 0.136], P(wS>0) = 0.994**,
  R-hat 1.00, 0 divergences - reliably positive, EE>SC sign, stable across both the
  constrained and unconstrained fits and across leave-one-mouse-out (range
  [0.048, 0.064]) ⇒ a real S-aligned signal, not driven by a few animals.
- **MCMC diagnostics (clean)**: after a non-centered random-intercept
  reparameterization, the final fit (4 chains / 2000 tune / 1000 draws /
  target_accept 0.95) has **R-hat = 1.00, ESS ≈ 4.2k-10k, 0 divergences**, and wS
  reproduced (0.076-0.078) across three independent runs ⇒ quotable as final.

### Subtlety the (r,S) figure exposed (matters for interpretation)
S is **not** uniformly EE-positive across tiers - its sign is set by the *overlap*
between the two grammars' tier transitions:
- **dominant**: A's dominant step (i→i+1) is only B's *secondary*, so a dominant
  sequence is cleanly diagnostic ⇒ S strongly EE+ / SC−.
- **secondary**: A's secondary step i→i+3 *is* B's *dominant* step, so a secondary
  sequence looks like the other grammar ⇒ S **flips** (EE-secondary S<0).
- **rare**: both grammars share identical rare transitions (i−1, i−2) ⇒
  non-diagnostic ⇒ S ≈ 0.
So the model predicts a clean semantic signal **only at the dominant tier** -
exactly where the model-free EE−SC effect is significant (n.s. at
secondary/rare). That convergence is itself supporting evidence; but it also
means the single positive wS is carried by the dominant tier and partly
*mis*-predicts secondary. A design talking point, not a bug.

**Read (final, B-D-constrained model)**: model-free EE−SC + reliably-positive wS
posterior + clean recovery all align. The per-cell posterior-predictive (Fig 7 -
NOTE: an earlier figure bug applied the fitted weights to *raw* features instead of
the SD-standardized features used in the fit, shrinking the semantic effect ~20×
and making the model look flat; fixed) shows the model **captures the dominant tier
well**: predicted EE-dominant 0.149 vs SC-dominant 0.124 (observed 0.170 vs 0.121)
 - right sign, ~½ magnitude, and it reproduces the SC-dominant trough. It **flips at
secondary** (predicts SC-sec > EE-sec; observed EE > SC) and is flat at rare.

Per-tier decomposition of the semantic weight (Fig 9) makes it exact:

| tier | wS fit on that tier alone |
|---|---|
| dominant | **+0.184** (strong) |
| secondary | −0.025 (i→i+3 flip) |
| rare | 0.000 (shared rare transitions) |
| **joint (reported)** | **+0.055** |

So the semantic effect is **strong and real at the clean dominant tier**; the
reported joint wS is **diluted ~3×** because one weight must also fit secondary (S
mis-aligned by the i→i+3 overlap) and rare (S uninformative). **Conclusion: a
robust model-free EE−SC effect + a reliably-positive S-term that is strong at the
dominant tier but diluted in the joint estimate by the grammar implementation** (we
did NOT add an interaction or redefine S). The behaviour is the result; the B-D+S
model captures it where S is well-defined, and the partiality is fully traced to
the grammar's i→i+3 / shared-rare structure - not a mis-set weight.

## Caveats / open items
- **Dominant-tier EE−SC is provisional** until the group split is confirmed fully
  clean - though the model-free result already shows it is consistent across both
  counterbalancing groups, which supports the semantic reading.
- Recovery was run at **full sim counts (500 param-recovery / 50 confusion)** and
  passed (FP rate 5.4%); the Bayesian fit is final (clean diagnostics, constrained).
- **Behavioural validity only.** A positive wS means the brain computes something
  S(t)-shaped; neural/mechanistic validity (belief-state decoding, a dopaminergic
  signal tracking S) is the next tier and is not established here.
- 13533 reinstatement + a full-sim Phase-1 rerun are the obvious next actions once
  the tracking artifact is cleaned.
