MaravallLab/aMAZEing-maze/tests/fixtures/sample_rois.csv

 | entrance1 | entrance2 | ROI1 | ROI2 | ROI3 | ROI4 | ROI5 | ROI6 | ROI7 | ROI8
xstart | 10 | 70 | 10 | 70 | 130 | 190 | 250 | 310 | 370 | 430
ystart | 10 | 10 | 80 | 80 | 80 | 80 | 80 | 80 | 80 | 80
xlen | 50 | 50 | 50 | 50 | 50 | 50 | 50 | 50 | 50 | 50
ylen | 50 | 50 | 50 | 50 | 50 | 50 | 50 | 50 | 50 | 50
