MaravallLab/aMAZEing-maze/docs/source/troubleshooting.rst

Troubleshooting
===============

Common Issues
-------------

1. **Camera not detected**:
   - Check USB connections and reinstall drivers if necessary.
2. **Motors not responding**:
   - Verify Arduino connections and ensure the correct sketch is uploaded.
