MaravallLab/aMAZEing-maze/hardware/3dmodels/eight_arm_maze/eight_arm_maze_plan.pdf

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

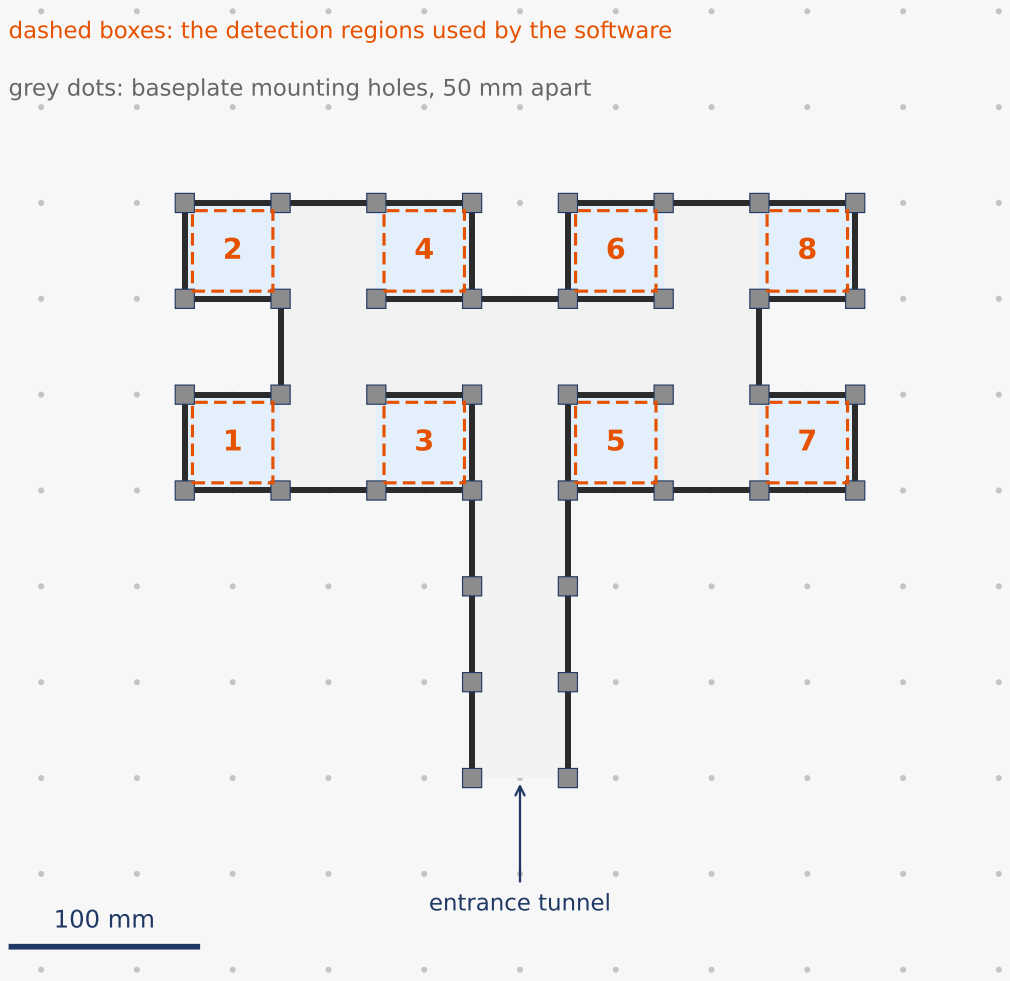
[picture p38: page 1]
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
