MaravallLab/aMAZEing-maze/(commit log)

2026-04-02 transferring the whole amazeing-maze architecture to this amazeing new official repository
    [Maze2_transfer_tunnel_higher.walls.3mf, cam_box.scad, camera_box_v2.FCStd, camera_box_v2.stl, camera_box_v3.FCStd, camera_box_v3.stl, camera_lid_v1.stl, cog.stl]
2026-05-23 debugged issues + added summary analysis plots
    [analysis.py, config.py, experiments.py, main.py, run_analysis.py]
2026-06-30 copied previous version of the maze in archive
    [Maze2_transfer_tunnel_higher.walls.3mf, cam_box.scad, camera_box_v2.FCStd, camera_box_v2.stl, camera_box_v3.FCStd, camera_box_v3.stl, camera_lid_v1.stl, cog.stl]
2026-09-14 Fix correctness issues found in the v2 review
    - Track the two tactile config CSVs (grating_maps, reward_sequences) that
    simplerCode.py needs; they were gitignored so a fresh clone could not
    run the tactile paradigm. Values are documented templates. Both scripts
    now resolve them relative to the script, not the working directory.
    - Close visits still open at a trial-block boundary: log them to the
    visit CSV and add their duration to time_spent instead of dropping them
    (DataManager.close_open_visits, called from main.py after every block).
    - Apply the speaker frequency-response compensation to the grammar tones
    (Audio.relative_gains + generate_melody(gain_fn=...)); gains are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
    [grating_maps.csv, reward_sequences.csv]
2026-09-14 Package the harness as an installable `amazeing` distribution
    - Move src/auditory and src/simplermaze into src/amazeing/{auditory,simplermaze}
    (git mv, history preserved); flatten auditory/modules/ into the package.
    - Absolute imports everywhere (amazeing.auditory.*); drop the sys.path hacks
    in tests/conftest.py and analysis/auditory/model_validation/config.py.
    - pyproject.toml (setuptools, src layout): runtime deps, `analysis` and `dev`
    extras, package data (speaker calibration CSV, tactile config CSVs), and
    console entry points: amaze-auditory, amaze-analyse-session, amaze-summary,
    amaze-summary-csv, amaze-grammar, amaze-tactile, amaze-tactile-segments.
    - Speaker calibrat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
    [frequency_response_speaker.csv, grating_maps.csv, reward_sequences.csv]
2026-09-15 Add YAML session config, custom stimulus mode and session manifest
    - session_config.py: load/save every ExperimentConfig field from a YAML
    file with a schema_version; unknown keys are rejected. main.py gains
    --config FILE (fields replace config.py defaults, CLI flags still
    override) and --write-config FILE (dump the effective config and exit).
    This file is the contract the graphical interface will read and write.
    - experiment_mode "custom": one stimulus per numbered ROI declared in
    cfg.custom_stimuli (tone / am_tone / wav / silent, optional label), with
    the standard 9-block structure and per-block shuffle; optional
    custom_block_minutes schedule. Existing modes are untou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
    [config.py, data_manager.py, experiments.py, main.py, session_config.py]
2026-09-15 Add the graphical application (amaze-app) and the Windows build
    A PySide6 interface that is a thin layer over the command-line tools: it
    edits the YAML session config, draws ROIs, and starts sessions and
    analyses as child processes whose output it shows. The experiment loop is
    untouched; a session started from the app is reproducible from the config
    file it writes to <recordings>/session_configs/.
    - src/amazeing/app: main window with five tabs (auditory session with the
    full config form and custom stimulus-to-ROI table, speaker calibration
    table editor with plot, analysis runner with figure preview, grammar
    training playback, tactile session launcher); process_panel runs a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
2026-09-15 Restore hyphenated abbreviations broken by the punctuation sweep
    The sweep rewrote every en/em dash as a spaced hyphen, which also hit
    unspaced compounds: B-D (Brielmann-Dayan) became B - D, r-S became
    r - S, 4.2k-10k became 4.2k - 10k. Using the v1.0-thesis content as
    ground truth, only the dashes that were unspaced there are rejoined;
    dashes used as sentence punctuation keep their spaces.
2026-09-15 Make every experiment mode configurable, and show the stimulus
    Interface
    - One parameter panel per experiment mode, shown only for the selected
    mode: pure-tone frequencies, interval tonal centre and interval choice,
    AM carriers/rates/depth, consonant-dissonant sets with a per-day preset
    that can be unlocked and edited, sequence patterns with a tone map,
    and the vocalisation silent-arm switch.
    - Arduino port and baud rate appear only when TTL output is ticked, with
    a note that TTL also changes the legacy block schedule.
    - Mouse wheel no longer changes a spin box or drop-down that does not have
    focus, which could silently alter a setting while scrolling the form.
    - "Reset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
    [audio.py, config.py, experiments.py]
2026-09-16 Colour the interface like the figures, add spectrogram and comparison views
    - palette.py gives the application one colour vocabulary, built on the
    STIM_COLORS already used by the session figures, so a stimulus category
    looks the same in the app as in the results. Categories for the
    non-grammar modes (smooth, rough, consonant, dissonant, tone, wav,
    pattern) are added in the same spirit. A test pins the shared keys so
    the two cannot drift apart.
    - Plots follow the window's light or dark theme instead of always being
    white on a dark window.
    - Waveform panel gains a view selector: one arm in detail now also shows a
    spectrogram, and "Compare all arms" stacks every arm's wav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
2026-09-16 Recycle a short frequency list far enough to fill every arm
    With fewer than half as many frequencies as arms, the list was doubled
    once and then sliced, which left it shorter than the arm count and raised
    IndexError when the trial builder indexed past the end. One frequency and
    eight arms hit this. Repeat as many times as needed instead, and reject an
    empty list with a clear message rather than failing later.
    Present since the thesis-era code; reachable now because the arm count and
    the frequency list are both editable from the interface.
    [experiments.py]
2026-09-16 Build a documentation site and slim the README to a front door
    The README had grown to 888 lines and was doing the job of a website,
    with another 928 lines in QuickGuide.md and analysis/README.md.
    - MkDocs Material site under docs/, published by a GitHub Actions
    workflow (needs Settings > Pages > Source set to GitHub Actions once).
    - README cut to 108 lines: what it is, install, run, layout, pointers.
    - Three tutorials written from scratch: run your first session, analyse a
    set of sessions, build and set up the rig.
    - New conceptual pages: the application, speaker calibration (why an
    uncalibrated speaker makes loudness look like preference), analysis
    overview, architecture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
2026-09-16 Refuse a session whose stimuli do not fill the arms
    Modes that build a fixed stimulus set need that set to match the arm
    count. A mismatch, such as eight intervals on four arms, previously only
    printed a warning and carried on building a trial table that did not
    match the maze.
    - ExperimentConfig.stimulus_arm_plan() reports how many arms a mode's
    stimuli fill and how the number breaks down; check_stimulus_count()
    raises with both numbers and the breakdown.
    - ExperimentFactory.generate_trials validates before building anything,
    so the failure names the problem instead of appearing later as a
    malformed table or an IndexError.
    - The two remaining print-and-continue paths ins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
    [config.py, experiments.py]
2026-09-16 Give the tactile paradigm equal weight in the documentation
    The README and the site read as though the platform were auditory with a
    tactile afterthought. It is two paradigms, equally developed.
    The tactile task, now described properly:
    - Three pairs of servo-driven 3D-printed gratings, one pair before every
    decision point, facing each other across the corridor. The vertical
    grating marks the correct way, the other is horizontal, so following
    vertical at both junctions reaches the rewarded arm.
    - A trial runs from the animal entering the maze to leaving it, scored as
    a hit, an incorrect choice or a miss.
    - The automated reward port and why it matters: a servo rocks the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
2026-09-16 Say when a recording is missing instead of calling the arm silent
    A vocalisation arm with no file selected showed as "This arm is silent",
    which is the same thing the interface says about a deliberately silent
    control arm. They are different situations: one is the design, the other
    is a setting you have not filled in.
    Underneath, a missing file is quiet rather than loud. Audio.load_wav
    returns silence and prints a note, so a session would run with a silent
    arm where a recording was intended and nothing in the data would say so.
    - ExperimentConfig.missing_audio_files() reports every recording the
    selected mode needs but cannot find, as readable lines;
    check_audio_files() rais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
    [config.py]
2026-09-16 See the camera and tune detection before a session records anything
    Detection was the one part of a session you could only judge from its
    results: the arm boxes, the binary threshold and the sensitivity were set
    blind, and a box in the wrong place or a threshold suited to yesterday's
    lighting only showed up in the data afterwards.
    amaze-camera-check opens a live view that records nothing. It measures the
    empty-maze baselines the way a session does, draws the arm boxes on the
    picture, and shows a bar per arm against the line that counts as occupied,
    amber when an arm sits close enough to that line to trip on a shadow.
    Threshold and sensitivity are sliders, so their effect is visible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
    [camera_check.py]
2026-09-16 Fix what the pre-push review turned up
    The packaging spec excluded tkinter, which the tactile session and its
    post-processing both import for their file dialogs. The packaged
    application would therefore have failed to start either of them, while
    working fine from source, where tkinter is always present. It is bundled
    now.
    dump_matrices annotated a local with Dict without importing it. Python
    does not evaluate local annotations, so this never raised, but it is
    wrong and misleads a reader.
    pre_porst_first_rew_roi drew each ROI twice, the second time through a
    variable named roi that does not exist in that scope, which would raise
    NameError. The duplicate draw is removed; the firs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
    [camera_check.py, pre_porst_first_rew_roi.py]
2026-09-16 Stop the test run aborting the process after it passes
    Every test passed and the process then exited with 0xC0000409. Qt widgets
    left alive at interpreter shutdown are destroyed after the QApplication
    itself, and Windows fails the process fast when that happens.
    It mattered because the build script gates on the exit code: it printed
    "Tests failed; not building" directly under a line saying 219 passed, and
    refused to build. Any continuous integration added later would have read
    it the same way.
    The QApplication fixture moves to conftest.py, shared by the whole run and
    deleting the top-level widgets before it goes. The suite now exits 0, and
    takes about a third less time, since th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
2026-09-16 Reorder the contributor list
    Changed in the README and the documentation landing page together, so
    the two stay in step.
2026-09-16 Correct the camera position: both paradigms film from below
    The build page and the tactile page said the auditory maze was filmed
    from above and only the tactile one through the floor. Both are filmed
    from below, through the infrared-transmitting plate, with the illuminator
    above.
    The camera arrangement therefore belongs in the shared assembly section
    rather than being introduced again as something the tactile paradigm
    adds, so that repeated subsection is gone and the checklists say where
    the camera is once.
2026-09-16 Describe how the picture is actually formed
    The camera and the illuminator are both below the plate and the room is
    dark. Infrared passes up through the floor, reflects off the white top of
    the maze, and returns to the camera, so the camera sees a lit white field
    and the animal, between the two, blocks it and reads black. The previous
    text put the illuminator above the maze, which describes a different
    apparatus.
    The white top and the darkened room were not documented at all. The top
    is now in the parts table, since without it there is no bright field and
    nothing to detect against, and the lighting step says to turn the room
    lights off rather than merely to avoid daylight.
2026-09-16 Say that the maze tops are printed, and that they are missing
    One top per configuration, four arms for the tactile decision tree and
    eight for the auditory maze, printed in white because the brightness of
    the picture depends on it.
    The models are not in the repository, so the page now says so plainly
    rather than listing a part nobody can obtain. They belong in
    hardware/3dmodels/maze_tops/ alongside the other printed parts.
2026-09-16 Give the site the colour language of the figures
    The documentation used Material's default indigo, which appears nowhere
    else in the project. It now takes its colours from STIM_COLORS in
    amazeing.auditory.analysis, the palette the result figures and the
    application already share, so a reader who has seen a session figure
    recognises the same blue on the site.
    The two paradigms get one colour each, warm against cool: auditory blue
    and tactile orange, carried by the rule under each section heading, the
    cards on the landing page and the diagrams. They carry equal weight in
    this project and the site should show that at a glance.
    The auditory flow diagram had no colour at all while the tactile o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
2026-09-16 Make the figures readable, and put a mouse on the site
    The screenshots are 1650px wide and Material caps content at 61rem, about
    976px, so on a large monitor every interface label was shown at roughly
    60 per cent and could not be read. Three changes, because no one of them
    was enough:
    The content column widens to 78rem on screens with the room, which keeps
    prose at a comfortable line length while giving figures somewhere to go.
    Wide figures and the diagrams then fill that column; model.png is left
    alone, being only 674px across and unimprovable by stretching.
    Every figure now opens at full resolution in a new tab when clicked,
    which is how you read a screenshot larger than any column the s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
2026-09-23 Record the parts as the paper describes them
    The dimensions page said the posts were 10 x 10 mm MakerBeam, and gave the
    panel width as both 40 mm and 50 mm. The paper says MakerBeam XL, which is
    15 x 15 mm, and panels 50 mm wide in two heights. A 50 mm panel cannot sit
    between two posts at 50 mm spacing, so it seats into the T-slot at each end.
    Which panel goes on which maze was not written down anywhere: the eight-arm
    auditory maze uses the 100 mm panels on 100 mm posts, the four-arm tactile
    maze the 50 mm panels on 50 mm posts.
    The frame was recorded as bars of 620 mm and legs of 760 mm, in the future
    tense, from before it was built. It is 660 and 880. The earlier planning
    numbers are ke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
2026-09-23 Add a solid model and a scale plan of the eight-arm maze
    The eight-arm configuration was not described anywhere: no drawing, no model,
    and nothing that would let somebody rebuild it.
    The maze is acrylic panels held between posts on a plate drilled at 50 mm
    spacing, so its shape is a grid. maze_layout.json records which squares are
    floor, which edges carry a panel and where the boundary is open, and both the
    scale plan and the walls of the solid model are generated from it. Nothing is
    traced from a photograph, so the drawing is true to scale by construction and a
    correction is a change to one file.
    eight_arm_maze_modified.FCStd is the model of the rig as it stands: the maze,
    the table frame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
    [eight_arm_maze_modified.FCStd]
2026-09-24 Show the maze with its own materials, and add the camera and illuminator
    The model now carries the camera and the infrared illuminator under the
    baseplate, and every part has its own material, so the acrylic reads as
    acrylic. 115 objects, in the same 700 x 960 x 1151 mm envelope as before.
    The pictures on the hardware page were rendered from an exported mesh, which
    carries no colour, transparency or material, so the whole rig came out one flat
    colour. These come from FreeCAD itself. Two more were added with them: the maze
    with the covers off, which is the only view that shows panels seated in the
    post slots, and the covered maze from above.
    [eight_arm_maze_modified.FCStd]
2026-09-24 Take the security fixes for the four flagged build dependencies
    Dependabot reported 22 advisories on the default branch: 13 high, 8 moderate,
    one low. All of them are in packaging/requirements-lock.txt, and 19 of the 22
    are Pillow.
    pillow 12.0.0 -> 12.3.0
    fonttools 4.60.1 -> 4.60.2
    Pygments 2.19.2 -> 2.20.0
    pytest 9.0.2 -> 9.0.3
    Each moves to the lowest version that carries the fix, rather than the newest
    release, since this file exists to pin versions that have been tested together.
    None of the four is reachable from anything this code does. Nothing imports
    PIL: Pillow is here because matplotlib requires it, and every one of its
    advisories needs a hostile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
